MoCsabi/WRO2024-FE-StormsNGR/src/RaspberryPi/README.md

# Raspberry Pi code
The main file is [full.py](/src/RaspberryPi/full.py). The Open Challenge code starts at line `537`, Obstacle Challenge at line `1069`.
