MoCsabi/WRO2024-FE-StormsNGR/robot.jpg

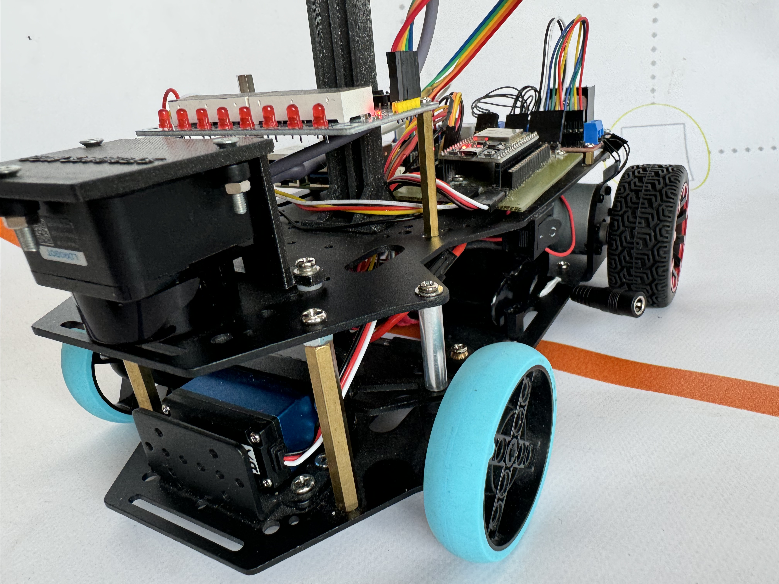
robot.jpg
