MoCsabi/WRO2024-FE-StormsNGR/schemes/diagram.png

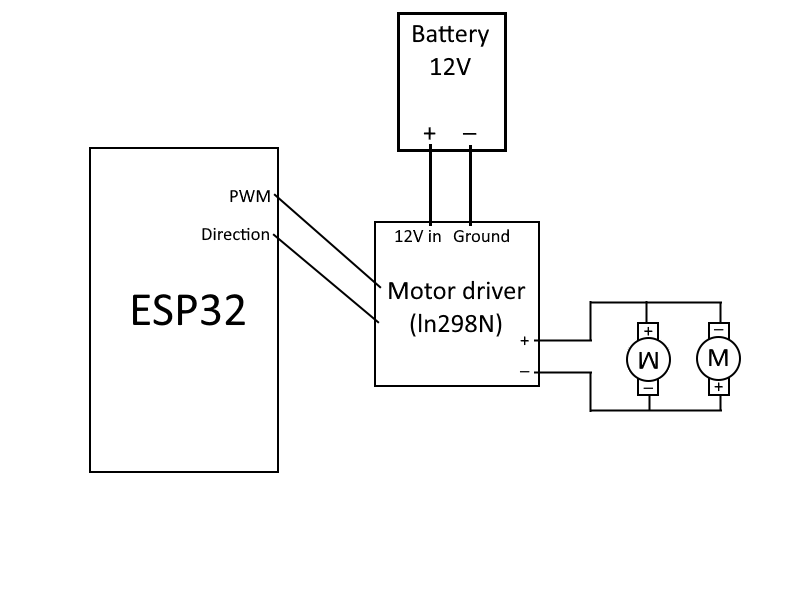
schemes/diagram.png
