MoCsabi/WRO2024-FE-StormsNGR/schemes/robot.png

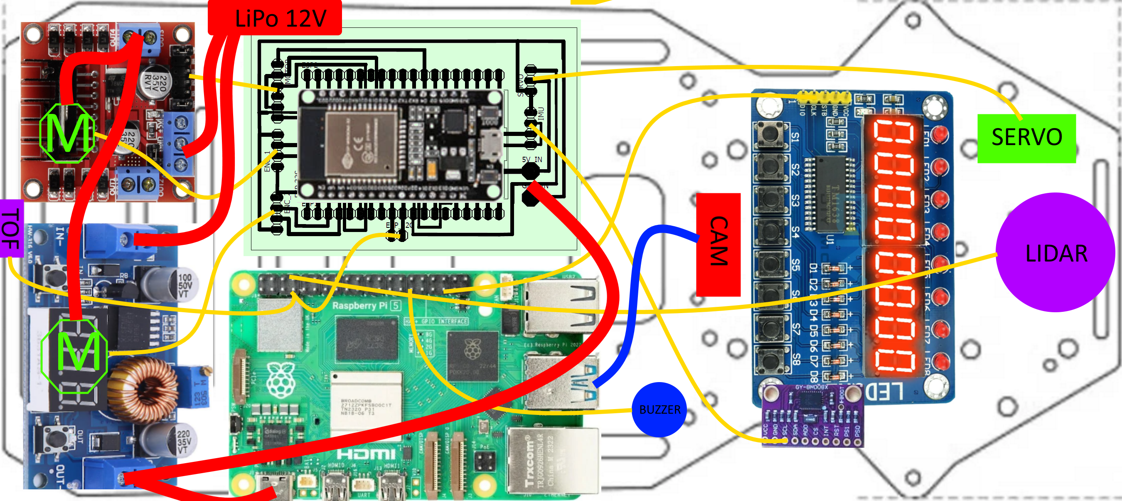
schemes/robot.png
