MoCsabi/WRO2024-FE-StormsNGR/spike.jpg

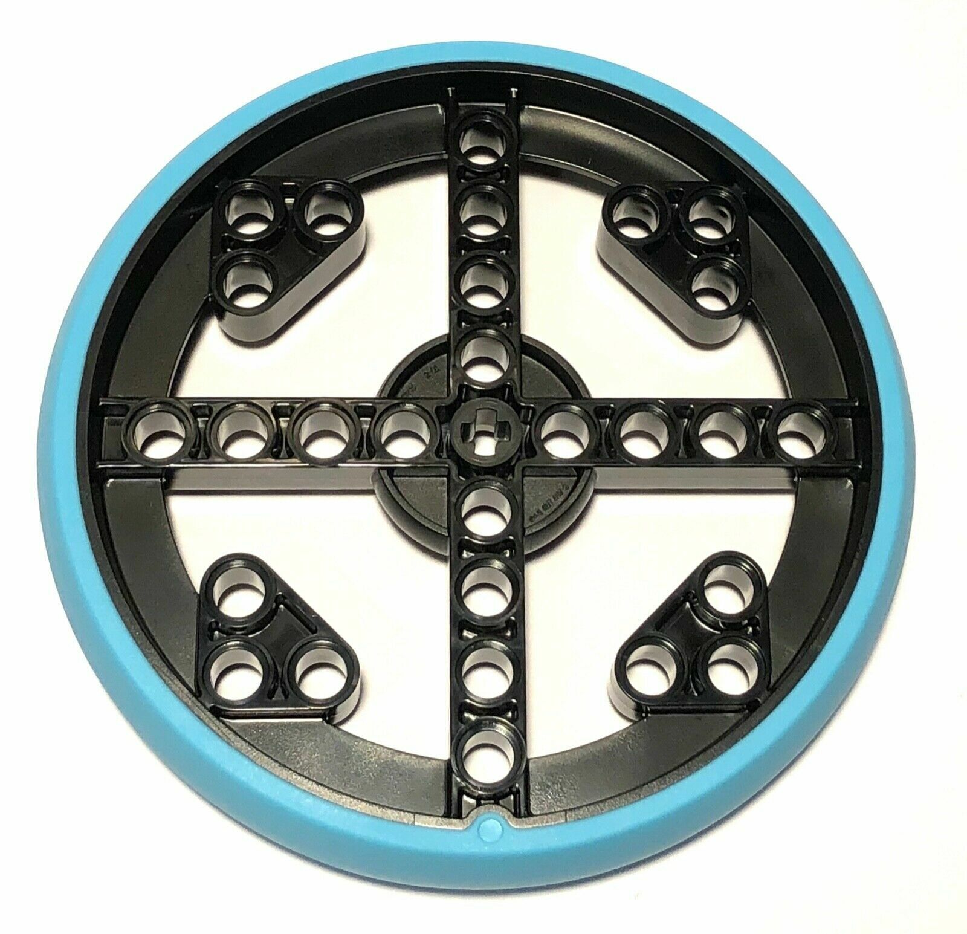
spike.jpg
