MoCsabi/WRO2024-FE-StormsNGR/src/straight_paths.png

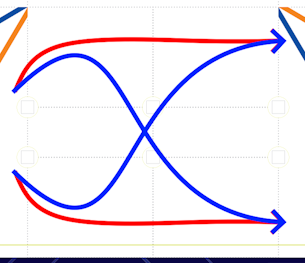
src/straight_paths.png
