MoCsabi/WRO2024-FE-StormsNGR/t-photos/funny.jpg

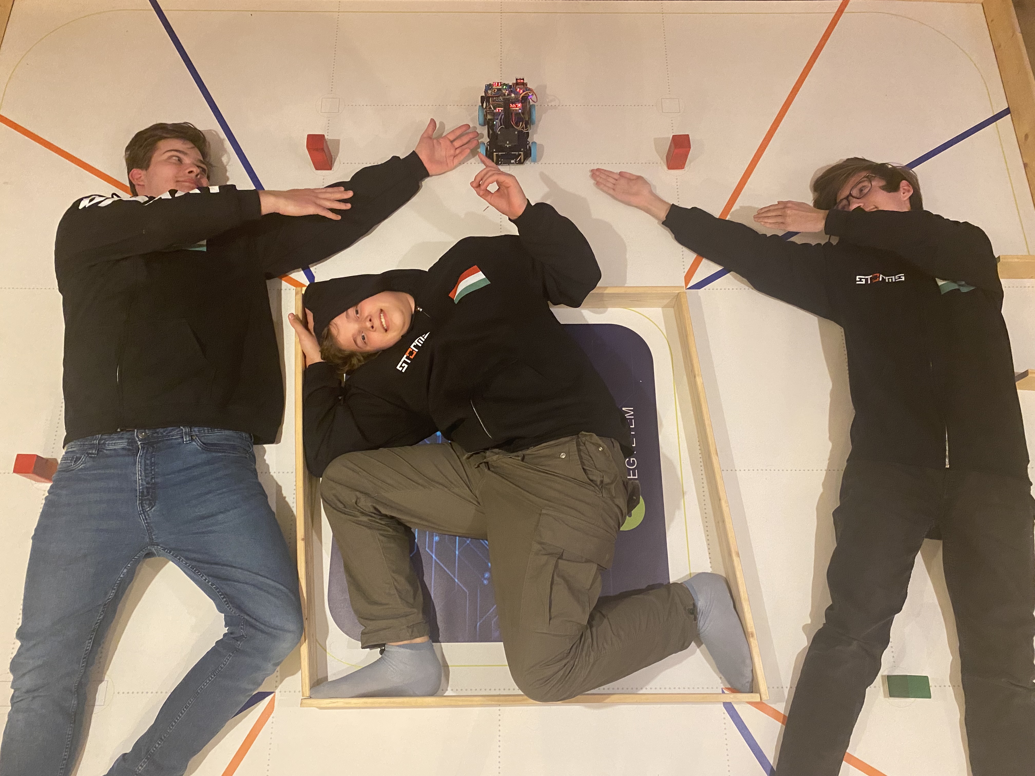
t-photos/funny.jpg
