MoCsabi/WRO2024-FE-StormsNGR/v-photos/back.jpg

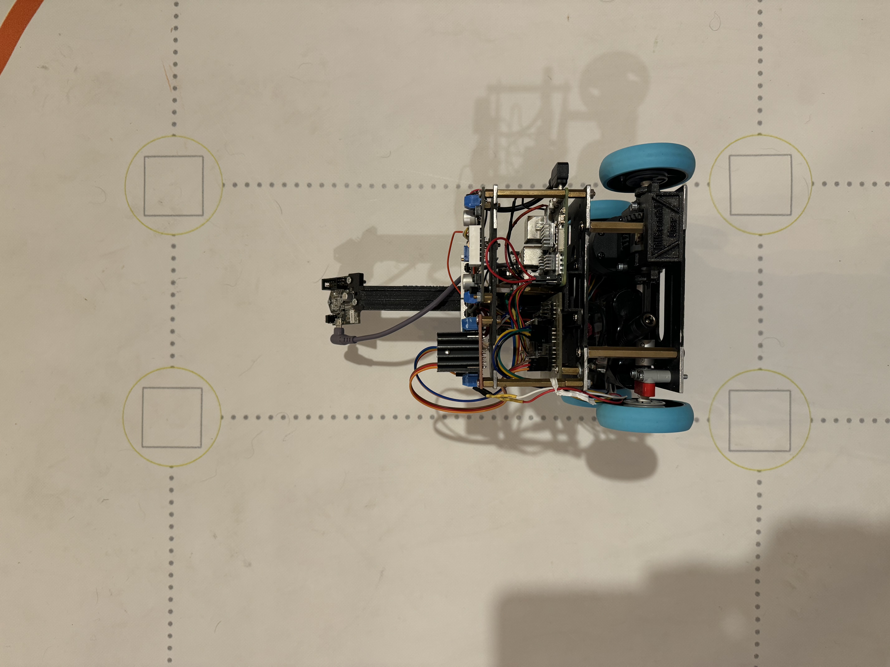
v-photos/back.jpg
