MoCsabi/WRO2024-FE-StormsNGR/v-photos/Bottom-deck.jpg

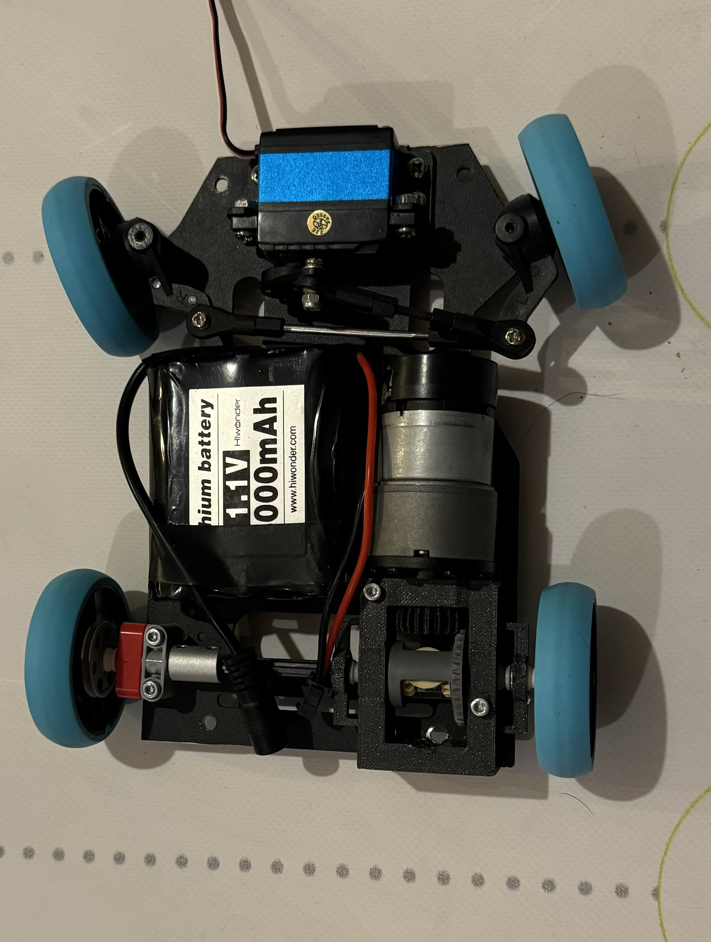
v-photos/Bottom-deck.jpg
