MoCsabi/WRO2024-FE-StormsNGR/v-photos/front.jpg

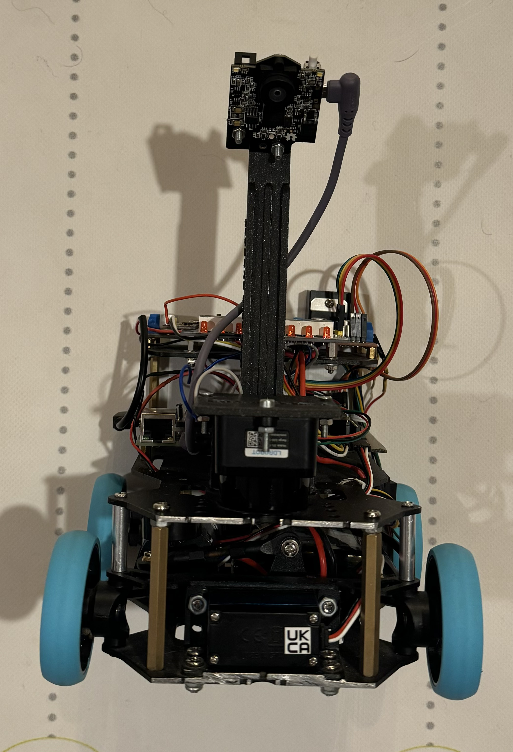
v-photos/front.jpg
