MoCsabi/WRO2024-FE-StormsNGR/v-photos/left.jpg

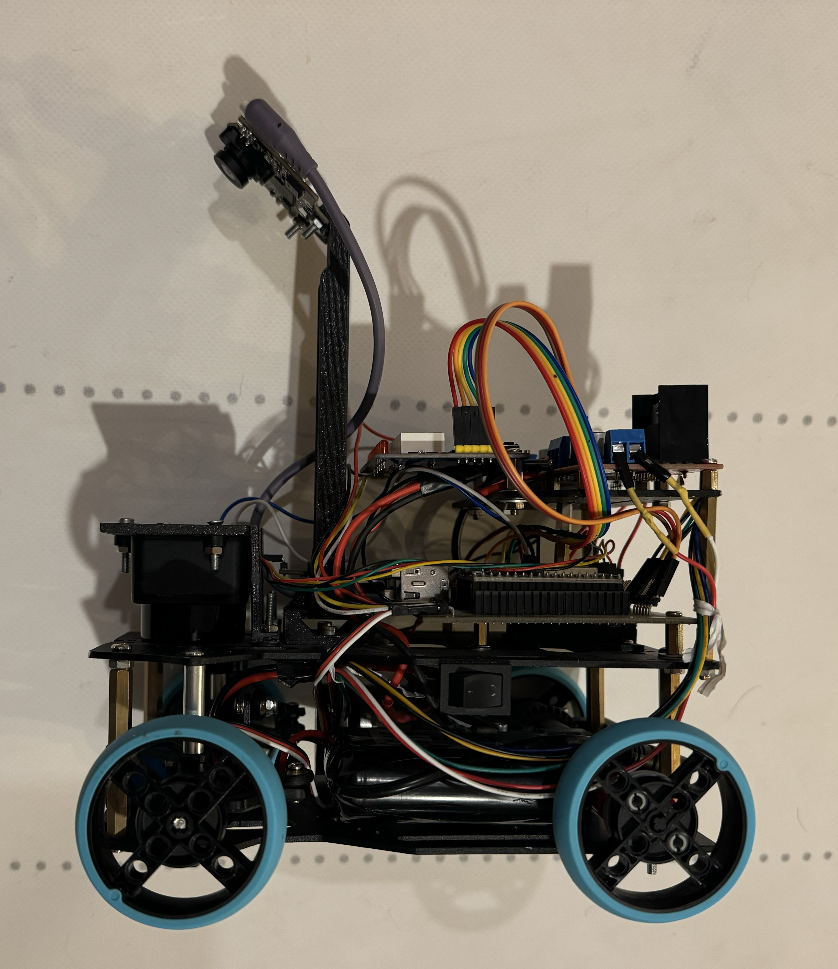
v-photos/left.jpg
