MoCsabi/WRO2024-FE-StormsNGR/v-photos/right.jpg

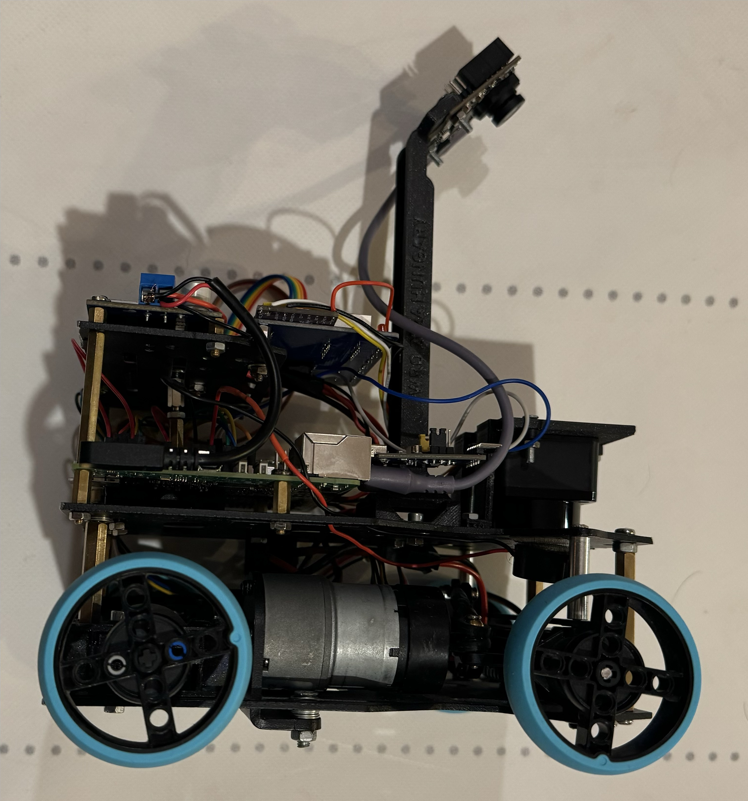
v-photos/right.jpg
