MoCsabi/WRO2024-FE-StormsNGR/v-photos/Top-deck.jpg

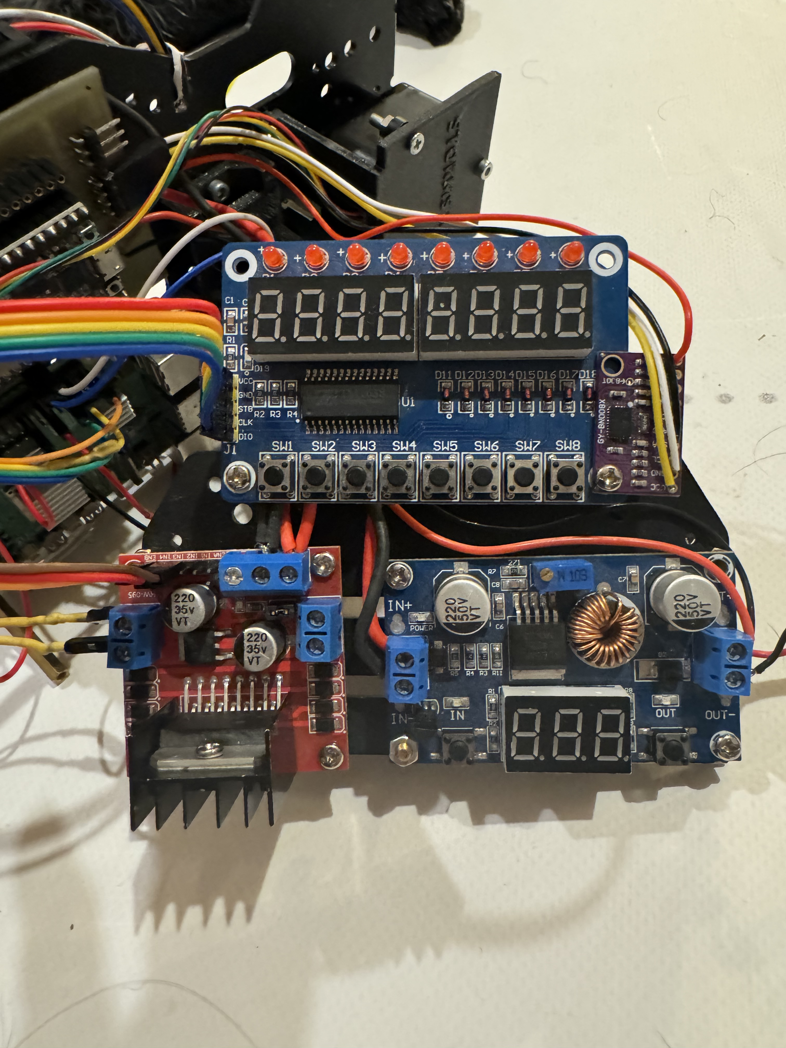
v-photos/Top-deck.jpg
