MoCsabi/WRO2024-FE-StormsNGR/v-photos/top.jpg

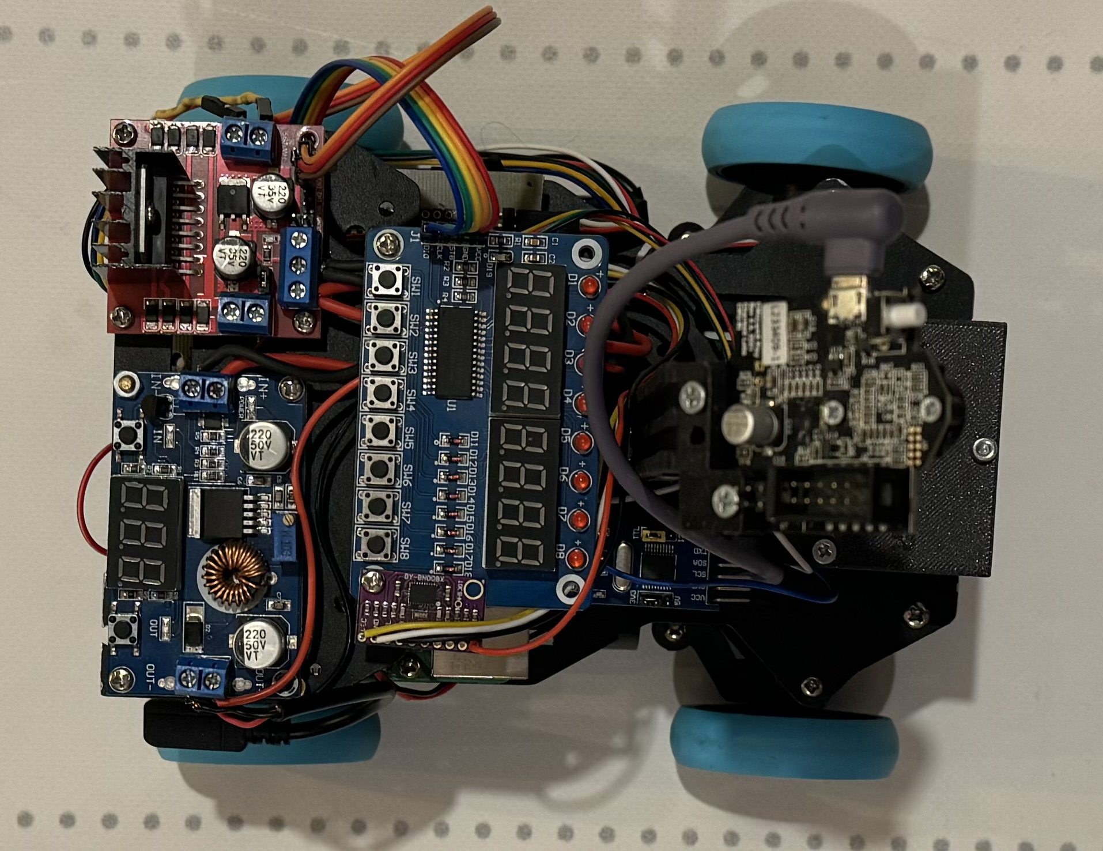
v-photos/top.jpg
