MoCsabi/WRO2024-FE-StormsNGR/models/Camera stand 3 v3.stl

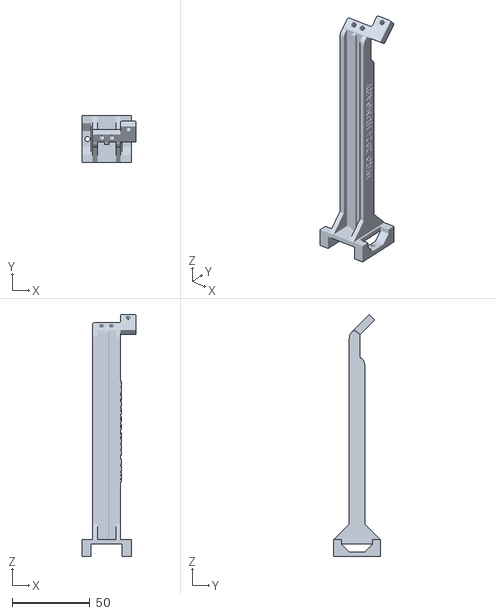
[picture p59: CAD file, 2024-11-25]
models/Camera stand 3 v3.stl
35.1 x 30.0 x 156.0
