MoCsabi/WRO2024-FE-StormsNGR/models/Lidar stand v2.stl

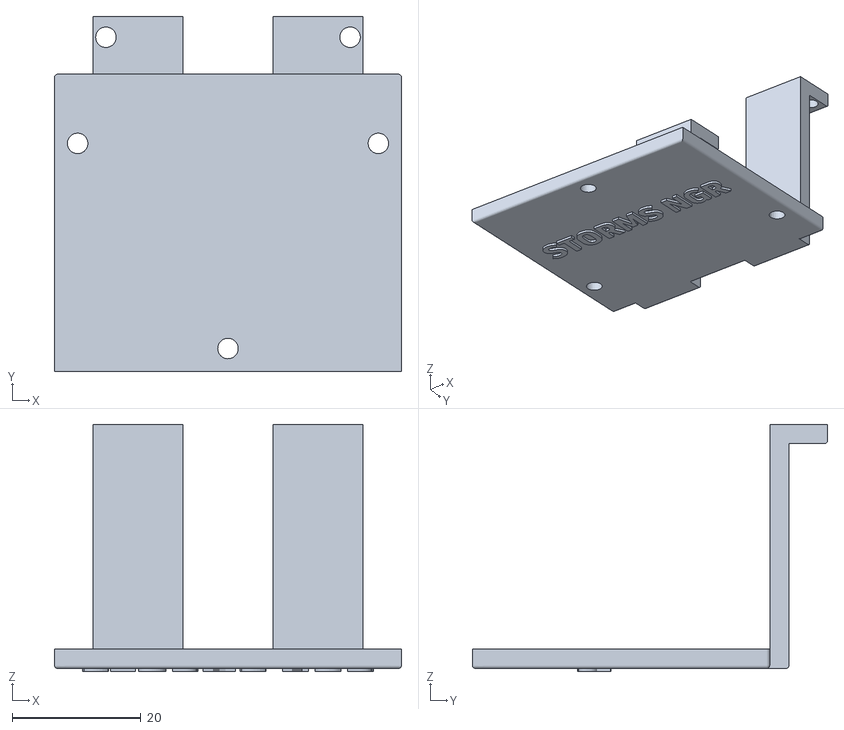
[picture p60: CAD file, 2024-11-25]
models/Lidar stand v2.stl
54.0 x 55.3 x 38.5
