MoCsabi/WRO2024-FE-StormsNGR/models/tunnel.stl

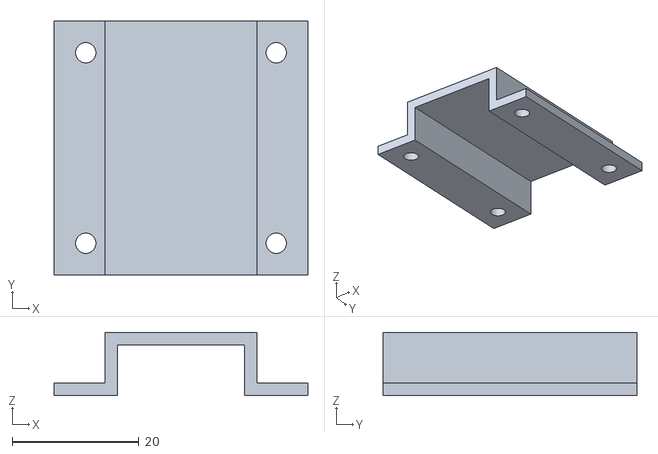
[picture p61: CAD file, 2024-11-25]
models/tunnel.stl
40.0 x 40.0 x 10.0
