MoCsabi/WRO2024-FE-StormsNGR/models/filled in gear with 6.2mm D axle v1.stl

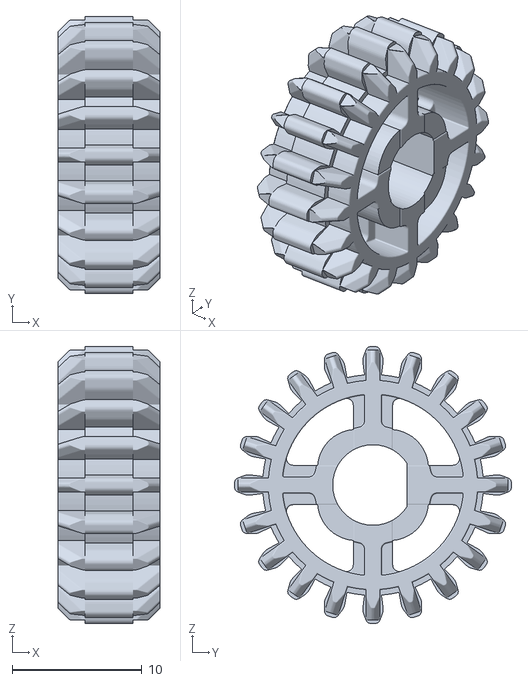
[picture p62: CAD file, 2024-11-25]
models/filled in gear with 6.2mm D axle v1.stl
7.86 x 21.3 x 21.3
