MoCsabi/WRO2024-FE-StormsNGR/models/Differential Gear House.stl

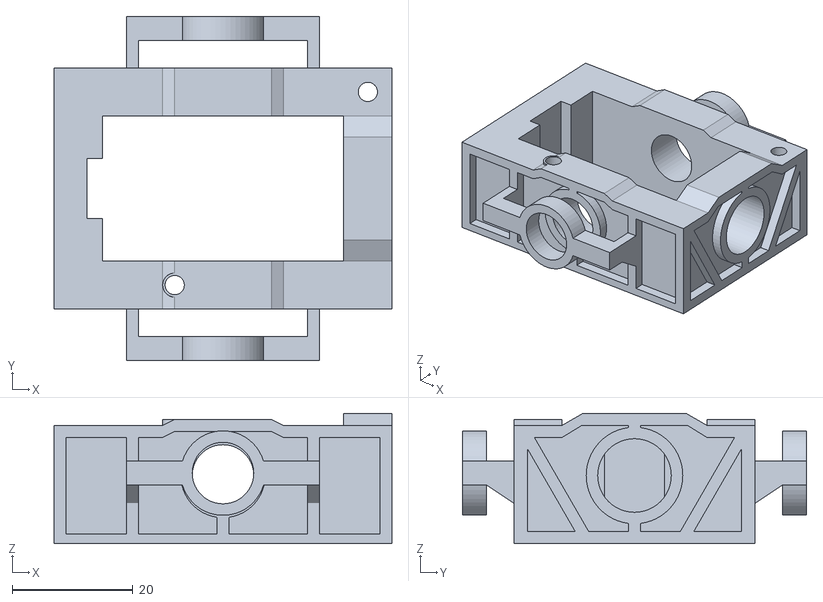
[picture p63: CAD file, 2024-11-25]
models/Differential Gear House.stl
56.0 x 57.0 x 21.6
