MoCsabi/WRO2024-FE-StormsNGR/models/Camera stand.stl

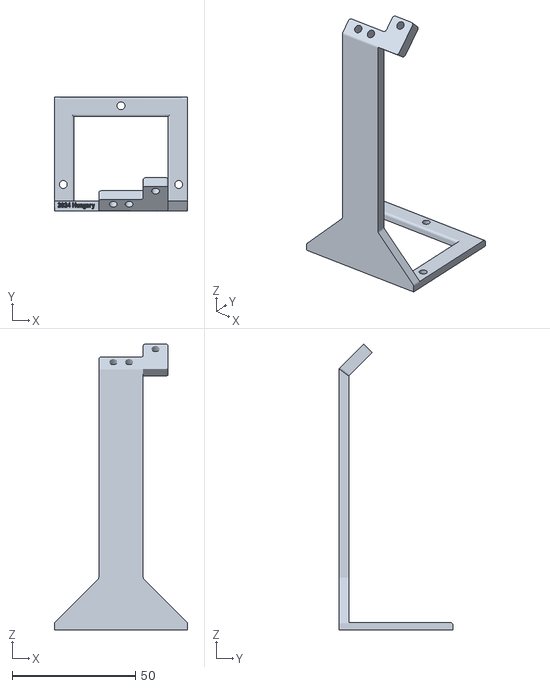
[picture p64: CAD file, 2024-06-26]
models/Camera stand.stl
54.0 x 46.3 x 116.0
