MoCsabi/WRO2024-FE-StormsNGR/models/Camera stand 2 v1.stl

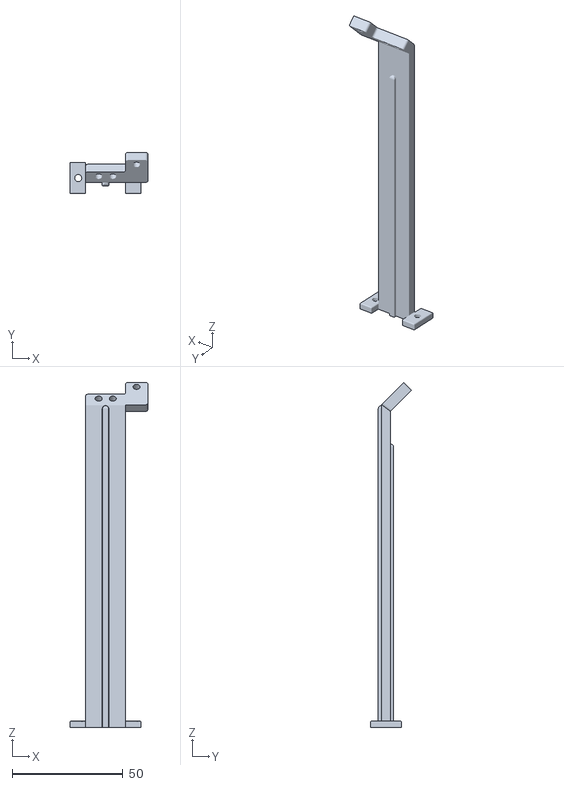
[picture p65: CAD file, 2024-06-26]
models/Camera stand 2 v1.stl
35.1 x 18.5 x 156.0
