MoCsabi/WRO2024-FE-StormsNGR/models/Lidar stand.stl

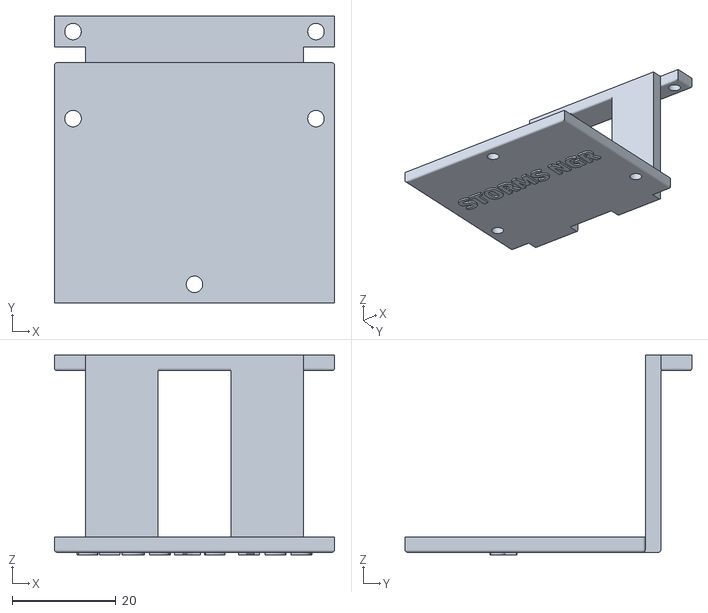
[picture p67: CAD file, 2024-06-26, an earlier design]
models/Lidar stand.stl
54.0 x 55.3 x 38.5
