MoCsabi/WRO2024-FE-StormsNGR/(list of files, cad)

Other CAD files:
models/Camera stand 3 v2.stl
models/Camera stand 2 v1.f3d
models/Camera stand 2 v2.f3d
models/Camera stand 2 v3.f3d
models/Camera stand 3 v3.f3d
models/Camera stand.f3d
models/Differential gear house.f3d
models/Lidar stand v2.f3d
models/Lidar_stand.f3d
models/filled in gear with 6.2mm D axle v1.f3d
models/tunnel.f3d
