MoCsabi/WRO2024-FE-StormsNGR/schemes/ESP_v8.sch

## EAGLE design schemes/ESP_v8.sch (2024-06-26)

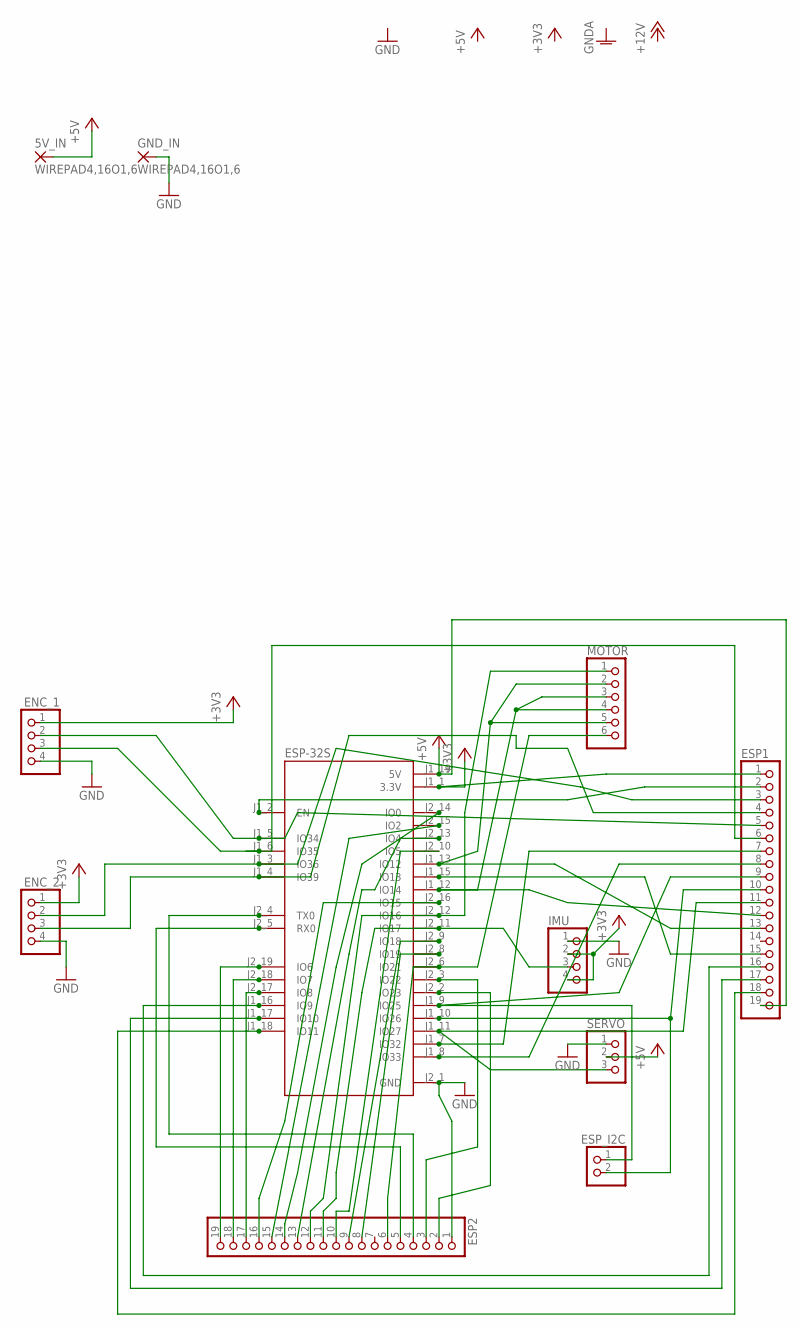
[picture p72: schematic ESP_v8.sch]

Parts:
5V_IN: WIREPAD4,16O1,6; 4,16O1,6
ENC_1, ENC_2: PINHD-1X4; 1X04
ESP1, ESP2: PINHD-1X19; 1X19
ESP-32S: NODEMCU-32S; MODULE_NODEMCU-32S
ESP_I2C: PINHD-1X2; 1X02
GND_IN: WIREPAD4,16O1,6; 4,16O1,6
IMU: PINHD-1X4; 1X04
MOTOR: PINHD-1X6; 1X06
SERVO: PINHD-1X3; 1X03

Connections:
+3V3: ENC_1.1, ENC_2.1, ESP1.1, ESP-32S.J1_1 (3.3V), IMU.2, IMU.4
+5V: 5V_IN.1, ESP1.19, ESP-32S.J1_19 (5V), SERVO.2
GND: ENC_1.4, ENC_2.4, ESP2.1, ESP-32S.J2_1 (GND), GND_IN.1, IMU.1, SERVO.1
unnamed: ESP1.11, ESP-32S.J1_11 (IO27), SERVO.3
unnamed: ESP2.12, ESP-32S.J2_12 (IO16), MOTOR.1
unnamed: ESP1.13, ESP-32S.J1_13 (IO12), MOTOR.2, MOTOR.5
unnamed: ESP1.12, ESP-32S.J1_12 (IO14), MOTOR.3, MOTOR.4
unnamed: ESP2.6, ESP-32S.J2_6 (IO21), MOTOR.6
unnamed: ENC_1.2, ESP1.5, ESP-32S.J1_5 (IO34)
unnamed: ESP2.11, ESP-32S.J2_11 (IO17), IMU.3
unnamed: ENC_2.3, ESP1.4, ESP-32S.J1_4 (IO39)
unnamed: ENC_2.2, ESP1.3, ESP-32S.J1_3 (IO36)
unnamed: ESP1.9, ESP-32S.J1_9 (IO25), ESP_I2C.1
unnamed: ESP1.15, ESP-32S.J1_15 (IO13)
unnamed: ESP1.7, ESP-32S.J1_7 (IO32)
unnamed: ESP2.14, ESP-32S.J2_14 (IO0)
unnamed: ESP2.15, ESP-32S.J2_15 (IO2)
unnamed: ESP2.13, ESP-32S.J2_13 (IO4)
unnamed: ESP1.8, ESP-32S.J1_8 (IO33)
unnamed: ESP2.16, ESP-32S.J2_16 (IO15)
unnamed: ESP2.8, ESP-32S.J2_8 (IO19)
unnamed: ESP2.3, ESP-32S.J2_3 (IO22)
unnamed: ESP2.2, ESP-32S.J2_2 (IO23)
unnamed: ESP1.2, ESP-32S.J1_2 (EN)
unnamed: ESP2.4, ESP-32S.J2_4 (TX0)
unnamed: ESP2.5, ESP-32S.J2_5 (RX0)
unnamed: ESP2.19, ESP-32S.J2_19 (IO6)
unnamed: ESP2.18, ESP-32S.J2_18 (IO7)
unnamed: ESP2.17, ESP-32S.J2_17 (IO8)
unnamed: ESP1.16, ESP-32S.J1_16 (IO9)
unnamed: ESP1.17, ESP-32S.J1_17 (IO10)
unnamed: ESP1.18, ESP-32S.J1_18 (IO11)
unnamed: ESP2.10, ESP-32S.J2_10 (IO5)
unnamed: ESP1.10, ESP-32S.J1_10 (IO26), ESP_I2C.2
unnamed: ENC_1.3, ESP1.6, ESP-32S.J1_6 (IO35)
unnamed: ESP2.9, ESP-32S.J2_9 (IO18)
