MoCsabi/WRO2024-FE-StormsNGR/src/RaspberryPi/decorators.py

'''Threading with decorators'''
from time import sleep
import threading

def func_thread(func):
    '''Runs automatically in a separate thread'''
    def threads(*args,**kwargs) -> threading.Thread:
        thread: threading.Thread = threading.Thread(target=func,args=args,kwargs=kwargs)
        thread.start()
        return thread
    return threads
