MoCsabi/WRO2024-FE-StormsNGR/(commit log)

2024-05-16 intial commit of code
    First committable version of code both for the raspberry pi and the ESP32 microcontroller
2024-06-15 Further improvements in the challange round
    Installed an ultrasonic sensor on the robot, improved obtsacle challange performance, made calibration easier and a lot of other small changes. Documentation of the code is still a work in progress.
2024-06-15 updated ESP code
    ESP code changes, such as handling an ultrasonic sensor and allowing PWM breaking (counter-drive) while slowing down
2024-06-24 switched to laser TOF distance sensor, improvements
    Improvements in both the open and the obstacle challange, installed a new laser time of flight distance sensor behind the robot instead of the ultrasonic sensor, further documentation of code, added binary dependencies, rewritten log library to be more reliable
2024-06-26 updated documentation
    [Camera stand 2 v1.f3d, Camera stand 2 v1.stl, Camera stand 2 v2.f3d, Camera stand 2 v3.f3d, Camera stand 3 v1.stl, Camera stand 3 v2.stl, Camera stand.f3d, Camera stand.stl]
2024-06-26 Update README.md
    Added what type of filament we used
2024-06-27 photos and framework documentation
    Added further documentation
2024-11-25 up-to-date documentation and source code added
    [pinouts.xlsx]
2024-11-25 Uploading the new models
    [Camera stand 3 v3.f3d, Camera stand 3 v3.stl, Differential Gear House.stl, Differential gear house.f3d, Lidar stand v2.f3d, Lidar stand v2.stl, filled in gear with 6.2mm D axle v1.f3d, filled in gear with 6.2mm D axle v1.stl]
2024-11-25 fixing naming inconsistency
    [Lidar_stand.f3d]
