MoCsabi/WRO2024-FE-StormsNGR/v-photos/Middle-deck.jpg

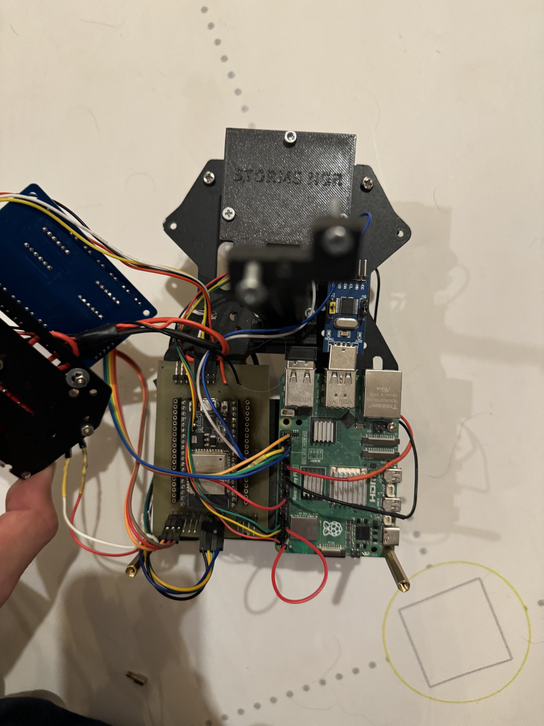
v-photos/Middle-deck.jpg
